sekigon-gonnoc/adns7530-breakout/schematic.pdf

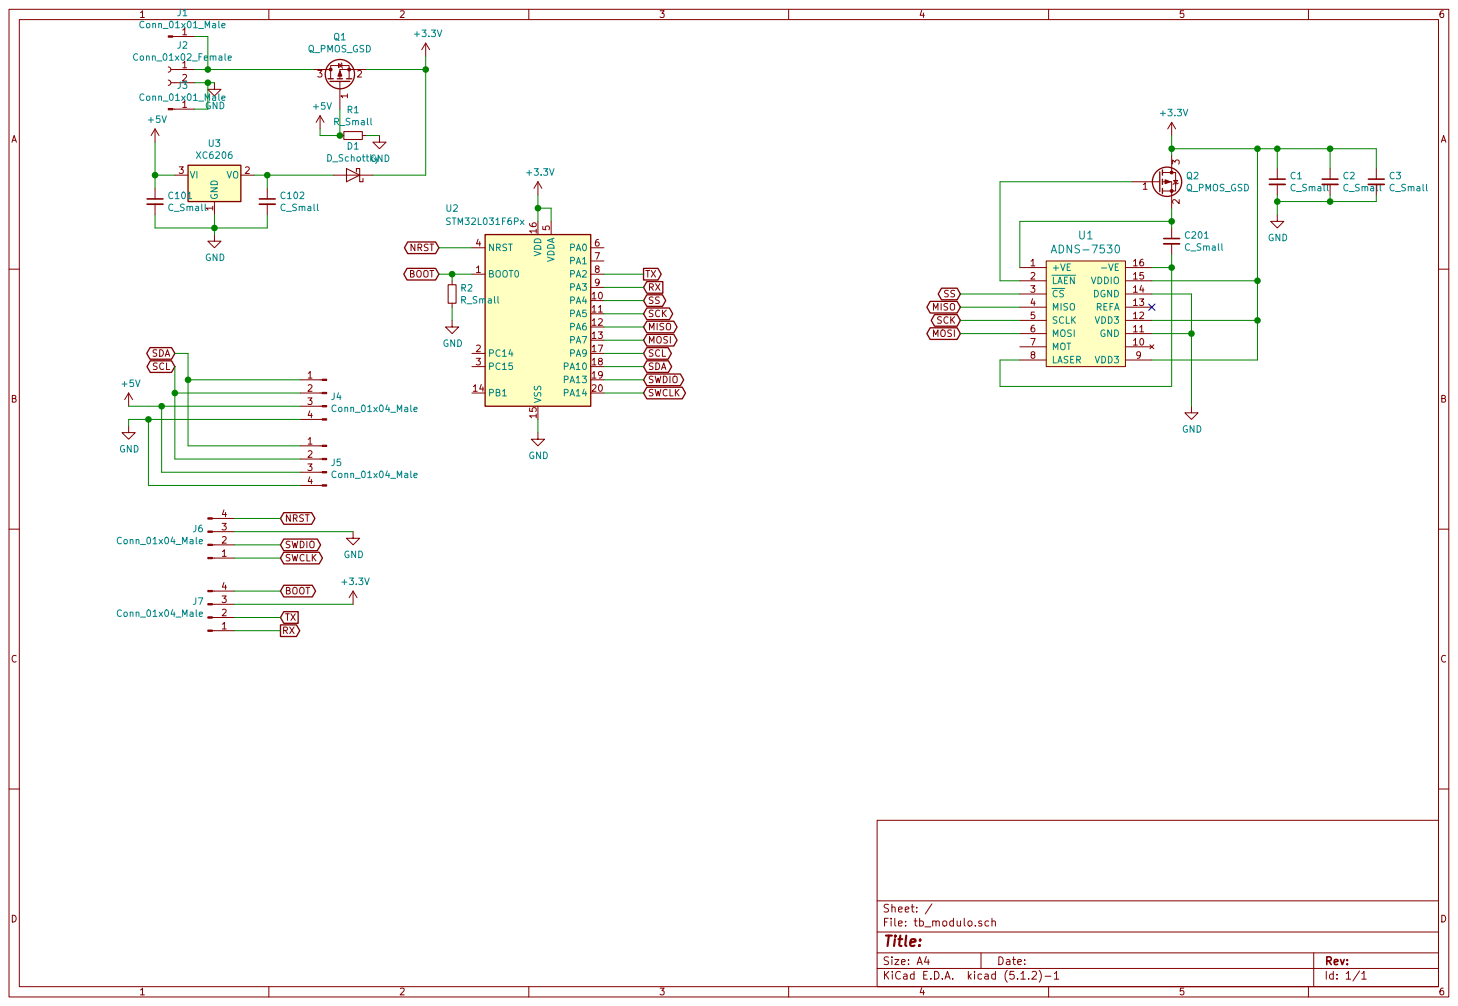
[picture p1: page 1]

SCK MISO MOSI GND
