sekigon-gonnoc/adns7530-breakout/firmware/tb_module.ioc

Mcu.UserName=STM32L031F6Px
PA10.Signal=I2C1_SDA
PA13.Signal=SYS_SWDIO
PA14.Signal=SYS_SWCLK
PA4.Signal=GPIO_Output
PA5.Signal=SPI1_SCK
PA6.Signal=SPI1_MISO
PA7.Signal=SPI1_MOSI
PA9.Signal=I2C1_SCL
